Leo-Nicolle/open-pod/docs/tools/pinout.md

---
layout: PinoutLayout
sidebar: false
hero:
  name: Pinout
  tagline: Which STM32F446 pin drives what, on the final opentone board (LQFP100) and on the Nucleo-F446RE prototype (LQFP64). Assignments come from the firmware pin maps.
  actions:
    - text: LQFP100 full table
      link: /tools/pinout-table-lqfp100
      theme: alt
    - text: LQFP64 full table
      link: /tools/pinout-table
      theme: alt
---

<PinoutViewer />
