Leo-Nicolle/open-pod/notes/stm32_production_optimization.md

# STM32 Production Optimization: Eliminating Empty Function Call Overhead

When defining functions that are active via flags during development but empty in production, keeping them in a **separate file** causes standard file-by-file compilation to lose CPU cycles. 

Because the compiler evaluates each `.cpp` file independently, it cannot see that the function body in the other file is empty. It assumes code exists and emits a `BL` (Branch with Link) instruction, wasting critical CPU ticks in production.

---

## The Cost of Unoptimized Empty Functions

On an ARM Cortex-M processor (STM32), calling an unoptimized empty function in a separate file costs **4 to 8+ CPU cycles** due to assembly overhead:

| Operation | Typical STM32 Ticks | Description |
| :--- | :--- | :--- |
| **`BL` (Branch Link)** | **1 – 2 Ticks** | MCU jumps to the function address and saves the return address. |
| **Stack Pushing** | **1 – 4+ Ticks** | Registers are pushed to the stack to preserve state. |
| **`BX LR` (Return)** | **1 – 3 Ticks** | MCU jumps back to the original execution path. |

---

## 3 Strategies to Achieve 0 Ticks in Production

### 1. Link-Time Optimization (LTO)
* **Best for:** Keeping your current structure with separate `.cpp` files unchanged.
* **How it works:** Instructs the linker to optimize across all compilation units. It catches the empty body at the final stage and strips out the call entirely.
* **PlatformIO Configuration (`platformio.ini`):**
  ```ini
  [env:your_stm32_board]
  platform = ststm32
  board = your_board
  framework = stm32cube ; or arduino
  build_flags = 
      -flto         ; Enables Link-Time Optimization
  ```

### 2. Header-Based Inline Functions
* **Best for:** Explicit control within C/C++ architecture without forcing global LTO.
* **How it works:** Shifting the `#ifdef` logic into the header file (`.h`) using the `inline` keyword. This gives the compiler full visibility in every file where it is included, guaranteeing zero-tick omission.
* **Implementation (`my_hooks.h`):**
  ```cpp
  #ifndef MY_HOOKS_H
  #define MY_HOOKS_H

  #ifdef ENABLE_DEBUG_FLAGS
      void myHook(); // Body lives in the .cpp file for debug mode
  #else
      inline void myHook() {} // Production mode: optimized to 0 ticks
  #endif

  #endif
  ```

### 3. Preprocessor Macro Stripping
* **Best for:** Purely architectural instrumentation, telemetry, or debug logging.
* **How it works:** Replaces the function signature entirely with a no-op macro before compilation even starts.
* **Implementation (`my_hooks.h`):**
  ```cpp
  #ifdef ENABLE_DEBUG_FLAGS
      void myHook();
  #else
      #define myHook() ((void)0) // Completely erased in production
  #endif
  ```
