Leo-Nicolle/open-pod/docs/tools/memory-layout.md

---
aside: false
---

# Memory layout

Where every byte of the firmware's memory goes: the STM32F446's 128 KB of internal RAM (static data, heap and stack) and the 8 MB PSRAM next to it. Hover a block for its size, click it to open its details and see what's inside; the table below lists every allocation with the file and variable that owns it.

<MemoryLayout />
