Leo-Nicolle/open-pod/docs/tools/bench-compare.md

---
aside: false
---

# Compare bench reports

Put two [bench](./bench) reports side by side: the headline numbers first, then every figure of every scenario, matched by sample, query or step. A starts on the newest report saved in the repo's `benchmarks/` folder; drop the one you just downloaded from the [live bench](./bench-live) on B. Nothing leaves the browser.

<BenchCompare />
