Leo-Nicolle/open-pod/software/src/sound/FLAC_README.md

# FLAC Support for VS1053b Audio Decoder

## Overview

This implementation provides FLAC (Free Lossless Audio Codec) support for the VS1053b audio decoder chip. FLAC support requires a software plugin to be loaded into the VS1053b's internal memory.

## Implementation Status

### Current Implementation

- ✅ FLAC plugin loading framework
- ✅ Clock configuration 0xC000 (4.5x = 55.3 MHz; SC_ADD only helps WMA/AAC, so the old 0x8800 ran FLAC at 3.5x)
- ✅ Plugin verification methods
- ✅ Integration with AudioPlayer class
- ⚠️ **Placeholder plugin data** (demonstration only)

### What's Needed for Production

- 🔄 **Complete FLAC plugin data from VLSI Solution**
- 🔄 Full 8208-word plugin arrays (atab and dtab)

## How FLAC Plugin Works

### Plugin Loading Process

1. **Clock Configuration**: Set VS1053b clock to 0xC000 (4.5x multiplier)
2. **Plugin Loading**: Iterate through 8208 data words:
   ```cpp
   for (uint16_t i = 0; i < 8208; i++) {
     writeRegister(atab[i], dtab[i]);
     waitForDREQ();
   }
   ```
3. **Verification**: Check clock configuration and chip responsiveness

### Working Example Structure

Based on the working FLAC driver example provided:

```cpp
// Address table - specifies register addresses
const uint8_t atab[8208] = { /* complete address data */ };

// Data table - actual plugin code and data
const uint16_t dtab[8208] = { /* complete plugin data */ };

// Loading methodology
for (uint16_t i = 0; i < 8208; i++) {
  VS1053_SciWrite(atab[i], dtab[i]);
}
```

## Obtaining Complete Plugin Data

### Official Source

The complete FLAC plugin must be obtained from **VLSI Solution** (the VS1053b manufacturer):

- Website: https://www.vlsi.fi/
- Product: VS1053b FLAC Decoder Plugin
- License: Check VLSI Solution's licensing terms

### Plugin Specifications

- **Size**: 8208 words (16,416 bytes)
- **Format**: Two arrays - address table (atab) and data table (dtab)
- **Capability**: FLAC decoding up to 48kHz/24-bit
- **Memory**: Loaded into VS1053b internal RAM

## File Structure

### Current Files

- [`VS1053_FLAC_plugin.h`](VS1053_FLAC_plugin.h) - Plugin data header (placeholder)
- [`VS1053_driver.h`](VS1053_driver.h) - FLAC method declarations
- [`VS1053_driver_config.cpp`](VS1053_driver_config.cpp) - FLAC plugin loading implementation

### Key Methods

```cpp
bool loadFLACPlugin();           // Load complete FLAC plugin
bool isFLACPluginLoaded();       // Verify plugin is loaded
void writeFLACPluginData(...);   // Write plugin data helper
```

## Integration with AudioPlayer

### FLAC File Detection

```cpp
// In AudioPlayer.cpp
if (isFlac) {
  if (!_driver.loadFLACPlugin()) return false;
  if (!_driver.isFLACPluginLoaded()) return false;
}
```

### Usage Example

```cpp
// Test FLAC playback
audioPlayer.startPlaying("track.flac");
```

## Technical Details

### Clock Configuration

- **FLAC Clock**: 0xC000 (4.5x multiplier)
- **Internal Clock**: ~55MHz with 12.288MHz crystal
- **Purpose**: Provides sufficient processing power for FLAC decoding

### Memory Requirements

- **Plugin Size**: 8208 words in VS1053b RAM
- **Arduino Memory**: ~16KB for plugin data arrays
- **Loading Time**: ~8-10 seconds (with progress indication)

### Performance

- **Supported Formats**: FLAC up to 48kHz/24-bit
- **Decoding**: Hardware-accelerated after plugin loading
- **Quality**: Lossless audio reproduction

## Development Notes

### Current Limitations

1. **Placeholder Data**: Current implementation uses demonstration data
2. **Plugin Source**: Complete plugin must be obtained separately
3. **License**: Check VLSI Solution licensing for commercial use

### Testing Status

- ✅ Plugin loading framework tested
- ✅ Clock configuration verified
- ⚠️ FLAC playback requires complete plugin data

### Next Steps

1. Obtain complete FLAC plugin from VLSI Solution
2. Replace placeholder arrays in `VS1053_FLAC_plugin.h`
3. Test with actual FLAC files
4. Optimize loading time if needed

## Troubleshooting

### Common Issues

1. **Plugin Not Loading**: Check SPI communication and DREQ timing
2. **Clock Issues**: Verify 0xC000 clock configuration
3. **Memory Issues**: Ensure sufficient Arduino memory for plugin arrays

### Debug Output

The implementation provides detailed debug output:

```
Loading FLAC plugin...
Configuring clock for FLAC plugin...
Loading FLAC plugin data (8208 words)...
Plugin loading progress: 0/8208
Plugin loading progress: 1000/8208
...
FLAC plugin loaded successfully
```

## References

- [VS1053b Datasheet](https://www.vlsi.fi/fileadmin/datasheets/vs1053.pdf)
- [VLSI Solution FLAC Plugin](https://www.vlsi.fi/)
- [Working FLAC Driver Example](provided by user)

---

**Note**: This implementation provides the framework for FLAC support. Complete functionality requires the official FLAC plugin data from VLSI Solution.
