Leo-Nicolle/open-pod/docs/pinout.md

---
# Redirect stub: this page moved to /tools/pinout
head:
  - - meta
    - http-equiv: refresh
      content: 0; url=/tools/pinout
sitemap: false
---

This page moved to [Tools › pinout](/tools/pinout).
