Leo-Nicolle/open-pod/docs/pinout-table.md

---
# Redirect stub: this page moved to /tools/pinout-table
head:
  - - meta
    - http-equiv: refresh
      content: 0; url=/open-pod/tools/pinout-table
sitemap: false
---

This page moved to [Tools › pinout-table](/tools/pinout-table).
