Leo-Nicolle/open-pod/docs/clickwheel.md

---
# Redirect stub: this page moved to /tools/clickwheel
head:
  - - meta
    - http-equiv: refresh
      content: 0; url=/open-pod/tools/clickwheel
sitemap: false
---

This page moved to [Tools › clickwheel](/tools/clickwheel).
