Leo-Nicolle/open-pod/docs/tools/bench-live.md

---
aside: false
sidebar: false
pageClass: bench-live-page
---

# Live bench

Watch the bench firmware live, drive the pod from here, and run the [benchmark](./bench) scenarios from the browser. The page talks to the Nucleo straight over USB with Web Serial (Chrome or Edge on desktop), so nothing needs installing. Without a board, <a href="?demo">try the demo</a>, which simulates one.

<BenchLive />

How to set it up, and what each chart shows: [Using the live bench](./bench#using-the-live-bench).
