Leo-Nicolle/open-pod/hardware/clickwheel.png

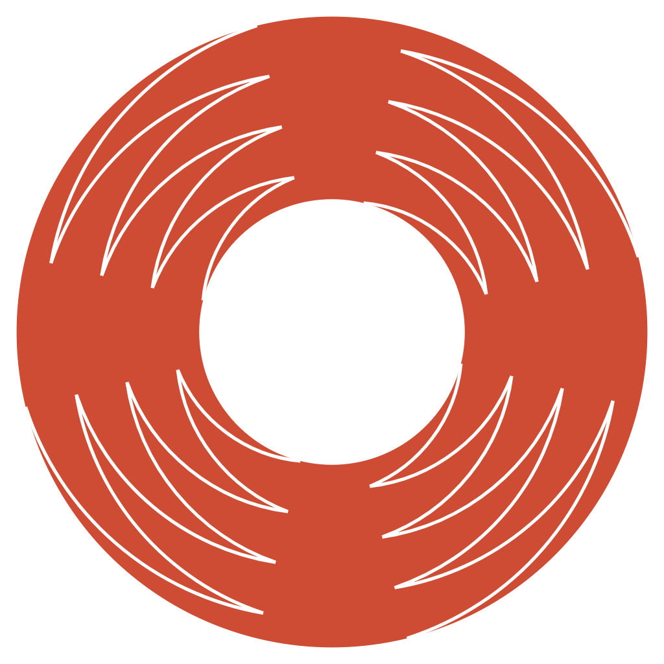
hardware/clickwheel.png
