Leo-Nicolle/open-pod/hardware/3dmodels/hirose-connector-8.stp

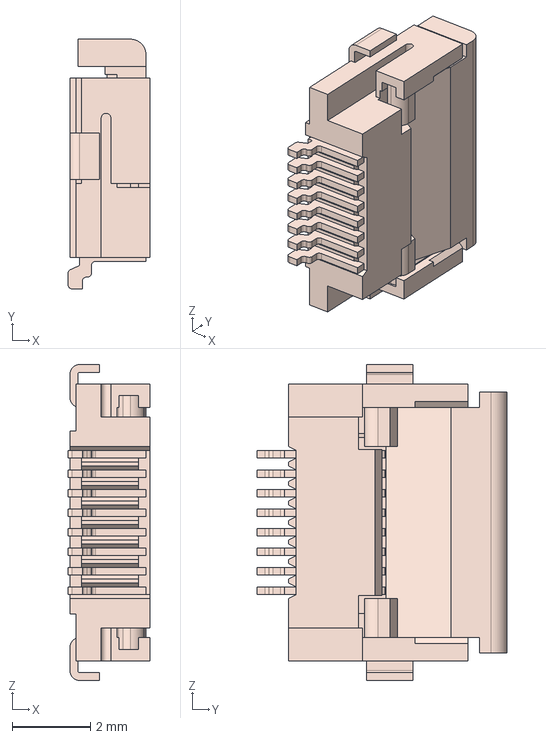
[picture p6: CAD file, 2025-07-06]
hardware/3dmodels/hirose-connector-8.stp
2.10 x 6.40 x 8.10 mm
