Leo-Nicolle/open-pod/hardware/openpod/jack/SJ-43515TS-SMT-TR.step

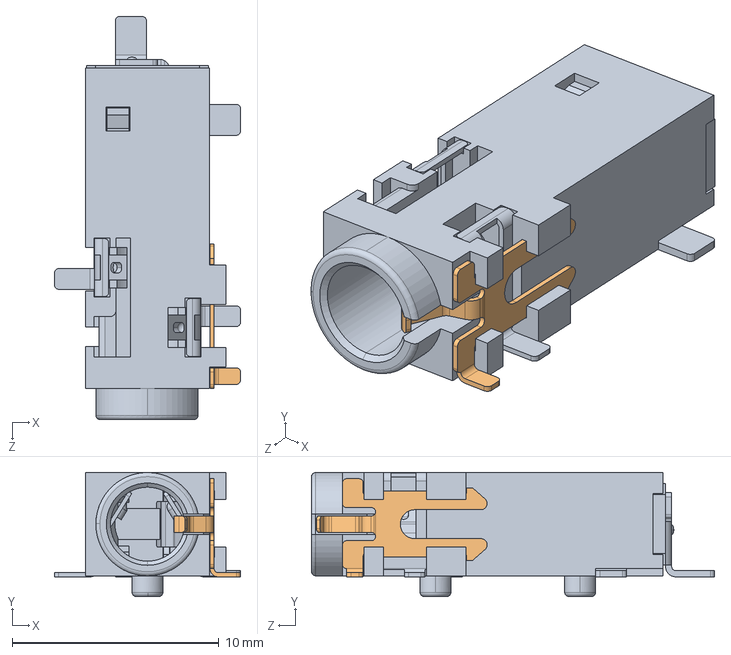
[picture p7: CAD file, 2025-05-11]
hardware/openpod/jack/SJ-43515TS-SMT-TR.step
9.00 x 6.00 x 19.5 mm
