Leo-Nicolle/open-pod/hardware/3dmodels/hirose-connector-40.stp

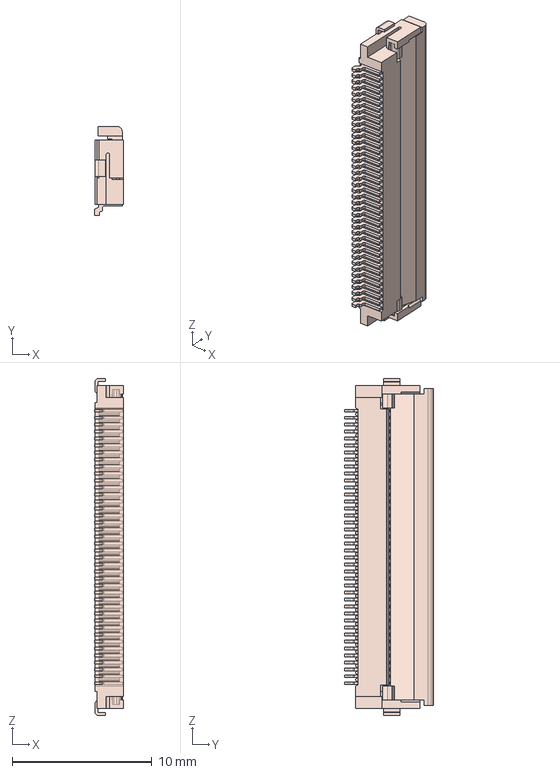
[picture p8: CAD file, 2025-05-11]
hardware/3dmodels/hirose-connector-40.stp
2.10 x 6.40 x 24.1 mm
