Leo-Nicolle/open-pod/hardware/3dmodels/NHD-2.4-240320CF-Cxxx#-F.STEP

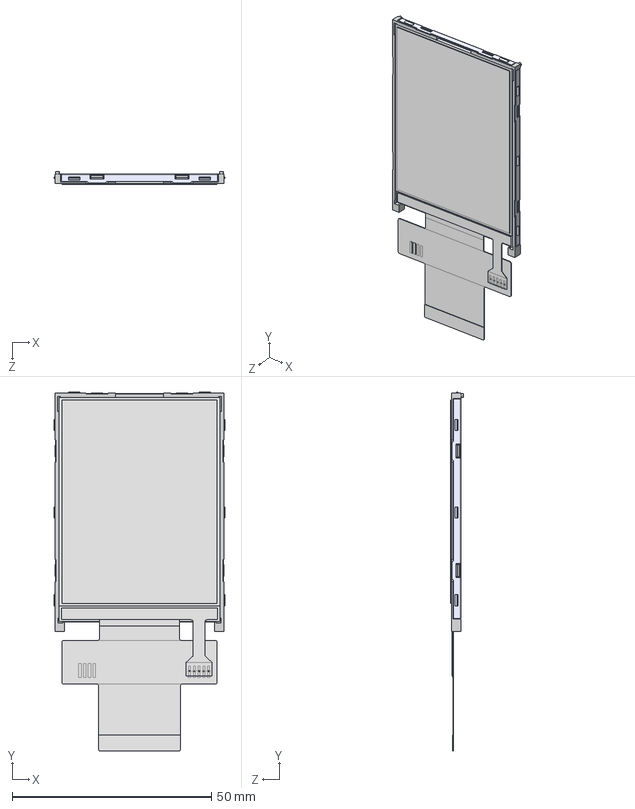
[picture p9: CAD file, 2025-05-11]
hardware/3dmodels/NHD-2.4-240320CF-Cxxx#-F.STEP
42.9 x 90.2 x 3.17 mm
bezel 2
V.A
Cable
Cable 2
frame
lens
