Leo-Nicolle/open-pod/hardware/3dmodels/SKQGAF.STEP

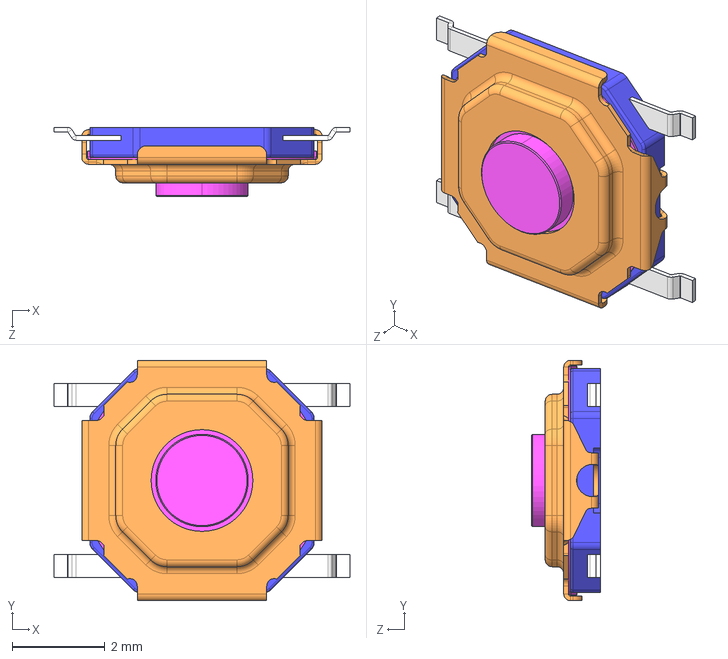
[picture p10: CAD file, 2025-05-11]
hardware/3dmodels/SKQGAF.STEP
6.40 x 5.20 x 1.50 mm
