Leo-Nicolle/open-pod/hardware/3dmodels/Same_Sky_SJ-43514-SMT-TR.step

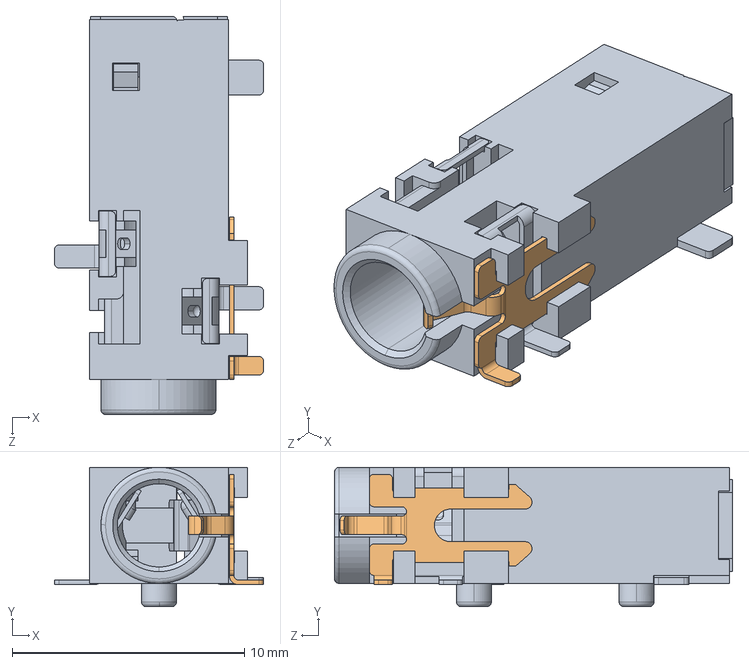
[picture p11: CAD file, 2025-05-11]
hardware/3dmodels/Same_Sky_SJ-43514-SMT-TR.step
9.00 x 6.00 x 17.1 mm
