Leo-Nicolle/open-pod/(list of files, cad)

Other CAD files:
hardware/parts/clickwheel-dev-holder.blend
