Leo-Nicolle/open-pod/docs/ui-builder.md

---
# Redirect stub: this page moved to /tools/ui-builder
head:
  - - meta
    - http-equiv: refresh
      content: 0; url=/tools/ui-builder
sitemap: false
---

This page moved to [Tools › ui-builder](/tools/ui-builder).
