Leo-Nicolle/open-pod/hardware/openpod/bt_devboard.kicad_pcb

## KiCad design hardware/openpod/bt_devboard.kicad_pcb (2026-09-20)

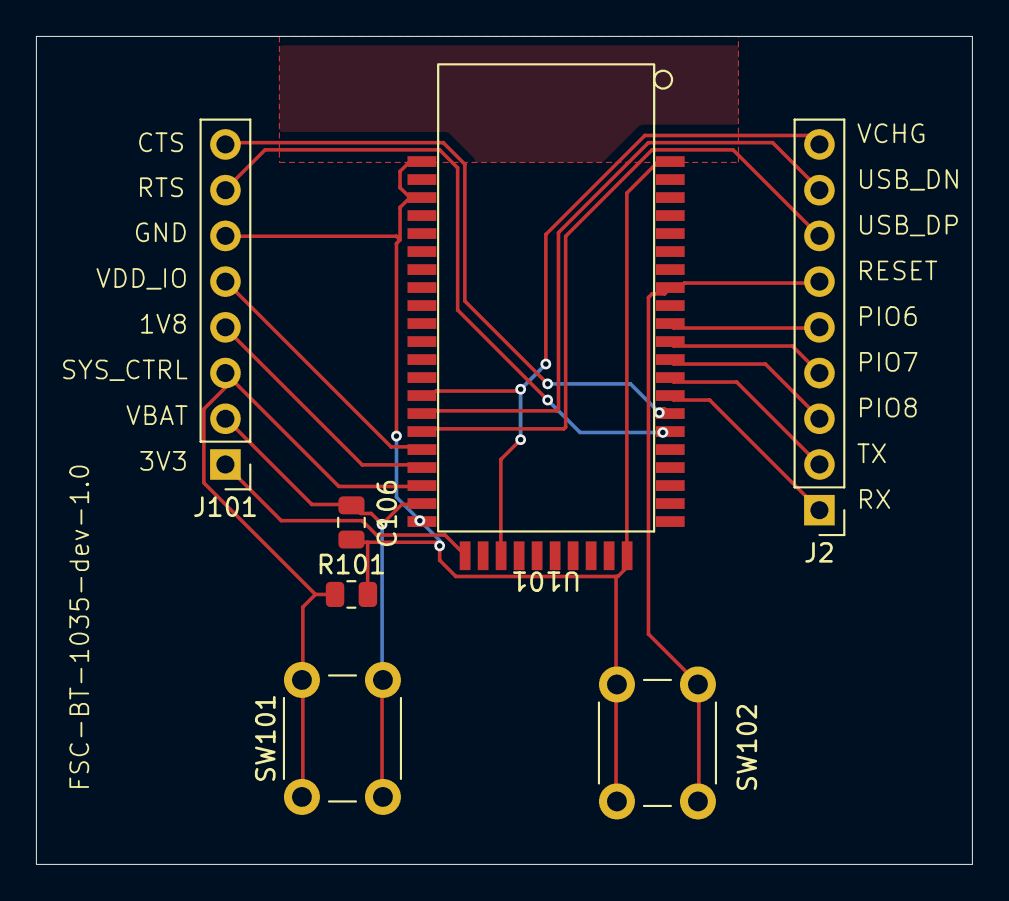
[picture p12: board bt_devboard.kicad_pcb from above]

Board: 2 copper layers, 52.0 x 46.0 mm, 7 parts (0 on the bottom side), 17 nets.

Parts:
C106: 10u; C_0805_2012Metric
J2: Conn_01x09; PinHeader_1x09_P2.54mm_Vertical
J101: POWER; PinHeader_1x08_P2.54mm_Vertical
R101: 100k; R_0805_2012Metric
SW101: PWR; SW_PUSH_6mm_H4.3mm
SW102: RST; SW_PUSH_6mm_H4.3mm
U101: FSC-BT1035; fsc-bt1035

Connections:
/BT_1V8: J101.4, U101.35 (1.8V_OUT)
/BT_3V3: J101.1, U101.31 (VDD_USB/3.3V_OUT)
/BT_CTS: J101.8, U101.15 (BT_CTS/PIO3)
/BT_GND: C106.2, J101.6, R101.2, SW102.2, U101.1 (GND), U101.22 (GND), U101.32 (GND), U101.50 (GND), U101.52 (GND)
/BT_PIO6: J2.5, U101.10 (PIO6)
/BT_PIO7: J2.4, U101.11 (PIO7)
/BT_PIO8: J2.3, U101.12 (PIO8)
/BT_RESET: J2.6, SW102.1, U101.8 (RESET)
/BT_RTS: J101.7, U101.16 (BT_RTS/PIO2)
/BT_RX: J2.1, U101.14 (BT_RX/PIO4)
/BT_SYS_CTRL: J101.3, R101.1, SW101.1, U101.34 (SYS_CTRL)
/BT_TX: J2.2, U101.13 (BT_TX/PIO5)
/BT_USB_DN: J2.8, U101.38 (USB_D-)
/BT_USB_DP: J2.7, U101.37 (USB_D+)
/BT_VBAT: C106.1, J101.2, SW101.2, U101.33 (VBAT_IN)
/BT_VCHG: J2.9, U101.29 (VCHG_SENSE), U101.39 (VCHG)
/BT_VDD_IO: J101.5, U101.36 (VDD_IO)
