Leo-Nicolle/open-pod/hardware/openpod/openpod.kicad_pcb

## KiCad design hardware/openpod/openpod.kicad_pcb (2026-09-20)

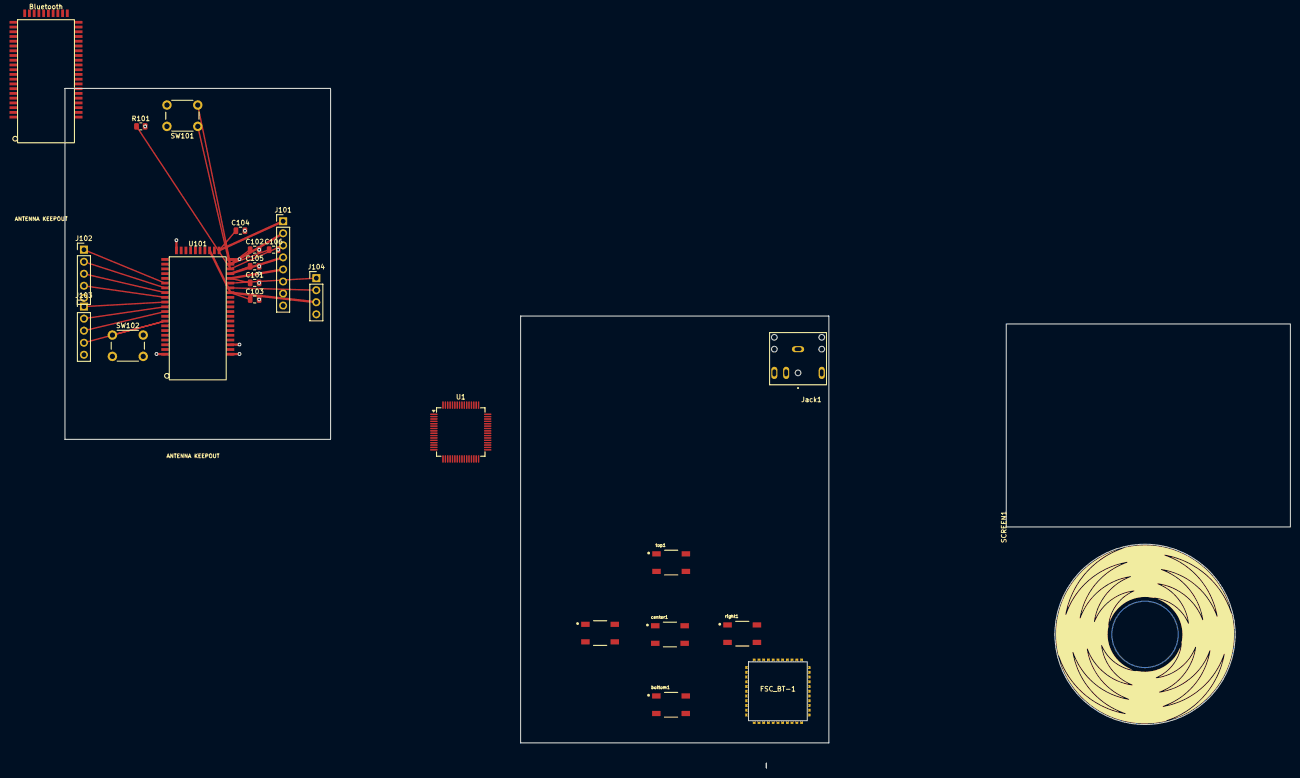
[picture p13: board openpod.kicad_pcb from above]

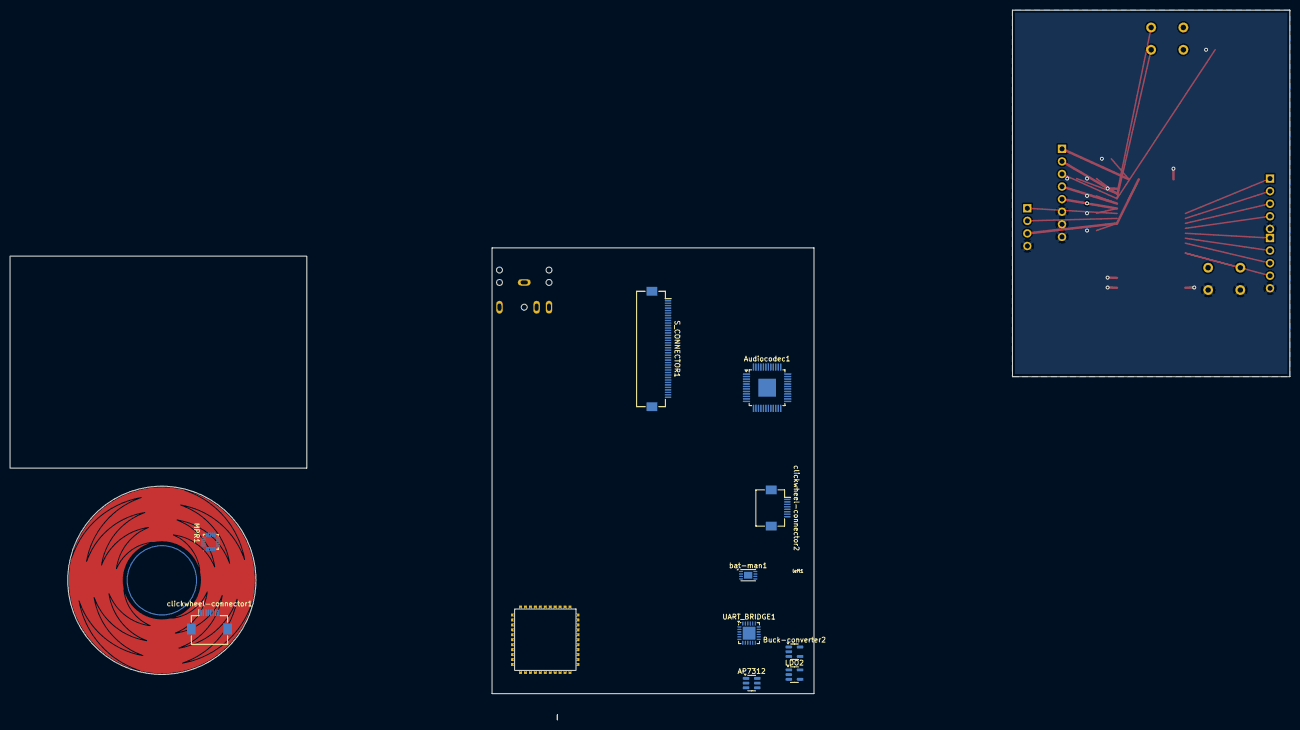
[picture p14: board openpod.kicad_pcb from below]

Board: 2 copper layers, 258.4 x 143.3 mm, 35 parts (10 on the bottom side), 42 nets.

Parts:
AP7312: SOT-23-6
Audiocodec1: VS1063; LQFP-48-1EP_7x7mm_P0.5mm_EP3.6x3.6mm
Bluetooth: fsc-bt1035
Buck-converter2: LM3671; TSOT-23-5
C101, C102, C103, C104, C105: 100n; C_0805_2012Metric
C106: 10u; C_0805_2012Metric
Clickwheel1: clickwheel_1
FSC_BT-1: fsc-bt1046
J101: POWER; PinHeader_1x08_P2.54mm_Vertical
J102: UART; PinHeader_1x05_P2.54mm_Vertical
J103: DEBUG; PinHeader_1x05_P2.54mm_Vertical
J104: USB; PinHeader_1x04_P2.54mm_Vertical
Jack1: SJ1-3524NG; CUI_SJ1-3524NG
LDO2: MIC5504-3.3YM5; SOT-23-5
MPR1: MPR121QR2; mpr121qr2
R101: 100k; R_0805_2012Metric
SCREEN1: nhd-2.4-240320cf-ctxif
SW101: PWR; SW_PUSH_6mm_H4.3mm
SW102: RST; SW_PUSH_6mm_H4.3mm
S_CONNECTOR1: Hirose_FH12-40S-0.5SH_1x40-1MP_P0.50mm_Horizontal
U1: STM32F446RCTx; LQFP-64_10x10mm_P0.5mm
U101: FSC-BT1035; fsc-bt1035
UART_BRIDGE1: CP2102N-Axx-xQFN24; QFN-24-1EP_4x4mm_P0.5mm_EP2.6x2.6mm
bat-man1: MCP73831-2-MC; DFN-8-1EP_3x2mm_P0.5mm_EP1.7x1.4mm
bottom1: SKQGAFE010; SW_SKQGAFE010
center1: SKQGAFE010; SW_SKQGAFE010
clickwheel-connector1, clickwheel-connector2: Hirose_FH12-8S-0.5SH_1x08-1MP_P0.50mm_Horizontal
left1: SKQGAFE010; SW_SKQGAFE010
right1: SKQGAFE010; SW_SKQGAFE010
top1: SKQGAFE010; SW_SKQGAFE010

Connections:
3.3-audio: AP7312.1 (OUT2), LDO2.5 (VOUT)
3.3V: LDO2.1 (VIN), LDO2.3 (EN)
+3.3V: AP7312.3 (EN2), AP7312.4 (EN1), AP7312.5 (IN)
AVDD: Audiocodec1.38 (AVDD0), Audiocodec1.43 (AVDD1), Audiocodec1.45 (AVDD2)
BT_1V8: C105.1, J101.4, U101.35
BT_3V3: C104.1, J101.1, U101.31
BT_CTS: J102.2, U101.15
BT_GND: C101.2, C102.2, C103.2, C104.2, C105.2, C106.2, J101.6, J101.7, J101.8, J102.5, J103.5, J104.4, R101.2, SW102.2, U101.1, U101.22, U101.32, U101.50, U101.52
BT_PIO6: J103.3, U101.10
BT_PIO7: J103.2, U101.11
BT_PIO8: J103.1, U101.12
BT_RESET: J103.4, SW102.1, U101.8
BT_RTS: J102.1, U101.16
BT_RX: J102.3, U101.14
BT_SYS_CTRL: J101.3, R101.1, SW101.1, U101.34
BT_TX: J102.4, U101.13
BT_USB_DN: J104.2, U101.38
BT_USB_DP: J104.1, U101.37
BT_VBAT: C102.1, C106.1, J101.2, SW101.2, U101.33
BT_VCHG: C103.1, J104.3, U101.29, U101.39
BT_VDD_IO: C101.1, J101.5, U101.36
CVDD: Audiocodec1.5 (CVDD0), Audiocodec1.7 (CVDD1), Audiocodec1.24 (CVDD2), Audiocodec1.31 (CVDD3)
GND: AP7312.2 (GND), Audiocodec1.4 (DGND0), Audiocodec1.16 (DGND1), Audiocodec1.20 (DGND2), Audiocodec1.21 (DGND3), Audiocodec1.22 (DGND4), Audiocodec1.35 (GND), Audiocodec1.37 (AGND0), Audiocodec1.40 (AGND1), Audiocodec1.41 (AGND2), Audiocodec1.47 (AGND3), Bluetooth.1, Bluetooth.22, Bluetooth.32, Buck-converter2.2 (GND), LDO2.2 (GND), UART_BRIDGE1.2 (GND), UART_BRIDGE1.25 (GND), bat-man1.6 (V_{SS})
GPIO_PULL: Audiocodec1.9 (GPIO2/DCLK), Audiocodec1.10 (GPIO3/SDATA), Audiocodec1.11 (GPIO6/I2S_SCLK), Audiocodec1.12 (GPIO7/I2S_SDATA), Audiocodec1.25 (GPIO5/I2S_MCLK), Audiocodec1.33 (GPIO0), Audiocodec1.34 (GPIO1), Audiocodec1.36 (GPIO4/I2S_LROUT)
IOVDD: Audiocodec1.6 (IOVDD0), Audiocodec1.14 (IOVDD1), Audiocodec1.19 (IOVDD2), Audiocodec1.32 (XTEST)
unnamed: Buck-converter2.3 (EN), Buck-converter2.4 (FB)
unnamed: UART_BRIDGE1.5 (VIO), UART_BRIDGE1.6 (VDD)
unnamed: bat-man1.1 (V_{DD}), bat-man1.2 (V_{DD})
unnamed: Clickwheel1.1 (top), MPR1.16 (ELEC8)
unnamed: Clickwheel1.2 (right), MPR1.15 (ELEC7)
unnamed: Clickwheel1.3 (bottom), MPR1.19 (ELEC11)
unnamed: Clickwheel1.4 (left), MPR1.9 (ELEC1)
unnamed: MPR1.1 (~IRQ), clickwheel-connector1.2 (IRQ)
unnamed: MPR1.2 (SCL), clickwheel-connector1.3 (SCL)
unnamed: MPR1.3 (SDA), clickwheel-connector1.4 (SDA)
unnamed: MPR1.4 (ADDR), clickwheel-connector1.5 (ADDR)
unnamed: MPR1.5 (VREG), clickwheel-connector1.6 (VREG)
unnamed: MPR1.6 (VSS), clickwheel-connector1.7 (VSS)
unnamed: MPR1.7 (REXT), clickwheel-connector1.8 (REXT)
unnamed: MPR1.20 (VDD), clickwheel-connector1.1 (VDD)
unnamed: U1.18 (VSS), U1.31 (VSS), U1.47 (VSS), U1.63 (VSS)
VBAT: bat-man1.3 (V_{BAT}), bat-man1.4 (V_{BAT})
