Leo-Nicolle/open-pod/software/src/rendering/ILI9341_GFX.h

#pragma once
#include "rendering/ILI9341_driver.h"
#include "sound/Spi1Bus.h"
#include "logging.h"
#include "ui/theme.h" // diagnostic-only: lets runDisplayDiagnostics() test the
                       // app's actual COLOR_* values, not just generic test colors
#include <Adafruit_GFX.h>
#include <Arduino.h>

class ILI9341_GFX : public Adafruit_GFX, public ILI9341_Driver {

public:
  // Constructor - Initialize Adafruit_GFX with display dimensions
  ILI9341_GFX() : Adafruit_GFX(320, 240) {}

  void begin() {
    setupPins();
    initILI9341();
    setRotation(0);
  }

  // Required Adafruit_GFX virtual methods
  void drawPixel(int16_t x, int16_t y, uint16_t color) override {
    if ((x < 0) || (x >= _width) || (y < 0) || (y >= _height))
      return;

    setWindow(x, y, x, y);
    writeData16(color);
  }

  // Bulk pixel transfers hold the SPI1 lock, in slices of PIXEL_SLICE
  // pixels: the VS1053 feeder interrupt then never clocks SPI1 while the 16
  // parallel data lines are switching at full speed (on the breadboard
  // wiring that corrupted bits on their way to the VS1053: audible glitches
  // while scrolling/animating, with on-time, complete feeding). Slicing
  // keeps each hold short (~0.15 ms) even across a long animation of
  // back-to-back transfers; a feeder tick that found the bus busy runs as
  // soon as the slice releases it (see spi1bus::release()). Pausing between
  // pixels is invisible to the panel.
  static const uint32_t PIXEL_SLICE = 1024;

  void fillRect(int16_t x, int16_t y, int16_t w, int16_t h,
                uint16_t color) override {
    if ((x >= _width) || (y >= _height))
      return;

    int16_t x2 = x + w - 1, y2 = y + h - 1;
    if ((x2 < 0) || (y2 < 0))
      return;

    // Clip to screen boundaries
    if (x < 0) {
      w += x;
      x = 0;
    }
    if (y < 0) {
      h += y;
      y = 0;
    }
    if (x2 >= _width) {
      w = _width - x;
    }
    if (y2 >= _height) {
      h = _height - y;
    }

    setWindow(x, y, x + w - 1, y + h - 1);
    fillPixels(color, (uint32_t)w * h);
  }

  // HIGH PERFORMANCE: Push array of pixels
  void pushPixels(uint16_t *colors, uint32_t count) {
    digitalWrite(TFT_DC, HIGH); // Data mode
    while (count > 0) {
      uint32_t n = count < PIXEL_SLICE ? count : PIXEL_SLICE;
      {
        spi1bus::Lock busLock;
        pushPixelSlice(colors, n);
      }
      colors += n;
      count -= n;
    }
  }

  // Push pixels with DMA support (if you add DMA later)
  void pushPixelsDMA(uint16_t *colors, uint32_t count) {
    // For now, fall back to regular push
    pushPixels(colors, count);

    // TODO: Implement DMA transfer
    // This would use DMA2 to transfer from memory to GPIOC->ODR
    // with hardware triggering of WR signal
  }

  // Optimized window push - send pixels to a defined window area
  void pushWindow(int16_t x, int16_t y, int16_t w, int16_t h,
                  uint16_t *colors) {
    // w*h is computed in signed 16/32-bit math; if a caller ever passes a
    // non-positive w or h (e.g. a transient negative width mid-animation),
    // the product goes negative and then silently wraps to a huge uint32_t
    // when handed to pushPixels() below - which turns into a multi-billion
    // iteration GPIO loop that looks exactly like a hang. Refuse it here,
    // before that conversion happens.
    if (w <= 0 || h <= 0)
      return;
    setWindow(x, y, x + w - 1, y + h - 1);
    pushPixels(colors, (uint32_t)w * (uint32_t)h);
  }

  // Fast vertical scroll (hardware accelerated if supported)
  void verticalScroll(int16_t top, int16_t scrolllines, int16_t offset) {
    // ILI9341 supports hardware scrolling
    writeCommand(0x33); // Vertical Scrolling Definition
    writeData16(top);
    writeData16(scrolllines);
    writeData16(320 - top - scrolllines); // Bottom fixed area

    writeCommand(0x37); // Vertical Scrolling Start Address
    writeData16(offset);
  }

  void drawFastVLine(int16_t x, int16_t y, int16_t h, uint16_t color) override {
    fillRect(x, y, 1, h, color);
  }

  void drawFastHLine(int16_t x, int16_t y, int16_t w, uint16_t color) override {
    fillRect(x, y, w, 1, color);
  }

  void fillScreen(uint16_t color) override {
    setWindow(0, 0, _width - 1, _height - 1);
    fillPixels(color, (uint32_t)_width * _height);
  }

  // Writes `pixels` copies of `color` into the current window, in locked
  // slices (see PIXEL_SLICE).
  void fillPixels(uint16_t color, uint32_t pixels) {
    digitalWrite(TFT_DC, HIGH); // Data mode
#ifdef BROKEN_NUCLEO
    // color is constant for the whole fill, so the relocated D14/D15 pins
    // only need setting once - they hold their level across every
    // pulseWR(). See the BROKEN_NUCLEO note in ILI9341_driver.h.
    writeBrokenBits(color);
#endif
    volatile uint32_t &bus = portCReg();
    const uint32_t word = portCWord(color);
    while (pixels > 0) {
      uint32_t n = pixels < PIXEL_SLICE ? pixels : PIXEL_SLICE;
      pixels -= n;
      spi1bus::Lock busLock;
      while (n >= 8) {
        bus = word;
        pulseWR();
        bus = word;
        pulseWR();
        bus = word;
        pulseWR();
        bus = word;
        pulseWR();
        bus = word;
        pulseWR();
        bus = word;
        pulseWR();
        bus = word;
        pulseWR();
        bus = word;
        pulseWR();
        n -= 8;
      }
      while (n--) {
        bus = word;
        pulseWR();
      }
    }
  }

  // One slice of pushPixels(); the caller holds the bus lock.
  void pushPixelSlice(uint16_t *colors, uint32_t count) {
#ifdef BROKEN_NUCLEO
    // Unlike fills, the color changes every pixel here, so D14/D15
    // (relocated to PA0/PA1, see ILI9341_driver.h) need a fresh
    // writeBrokenBits() call each iteration.
    while (count--) {
      uint16_t px = *colors++;
      GPIOC->BSRR = portCWord(px);
      writeBrokenBits(px);
      pulseWR();
    }
#else
    while (count >= 8) {
      GPIOC->ODR = *colors++;
      pulseWR();
      GPIOC->ODR = *colors++;
      pulseWR();
      GPIOC->ODR = *colors++;
      pulseWR();
      GPIOC->ODR = *colors++;
      pulseWR();
      GPIOC->ODR = *colors++;
      pulseWR();
      GPIOC->ODR = *colors++;
      pulseWR();
      GPIOC->ODR = *colors++;
      pulseWR();
      GPIOC->ODR = *colors++;
      pulseWR();
      count -= 8;
    }
    while (count--) {
      GPIOC->ODR = *colors++;
      pulseWR();
    }
#endif
  }

  void setupScroll(uint16_t TF, uint16_t scrollHeight, uint16_t BF) {
    // For landscape mode (rotation = 1), scrolling is horizontal visually
    // but still uses the vertical scroll registers internally

    // Set the scrollable region to full height (usually 240px)
    writeCommand(0x33); // VSCRDEF
    writeData(TF >> 8); // Top Fixed Area (TFA)
    writeData(TF & 0xFF);
    writeData(scrollHeight >> 8); // Vertical Scroll Area
    writeData(scrollHeight & 0xFF);
    writeData(BF >> 8); // Bottom Fixed Area (BFA)
    writeData(BF & 0xFF);
  }

  void setScrollOffset(uint16_t offset) {
    // For rotation 1, this visually scrolls from right to left
    writeCommand(0x37); // VSCRSADD
    writeData(offset >> 8);
    writeData(offset & 0xFF);
  }

  void setRotation(uint8_t r) override {
    rotation = r & 3;
    switch (rotation) {
    case 0: // 320x240 landscape
      _width = 320;
      _height = 240;
      writeCommand(0x36);
      writeData(0xE8);
      break;
    case 1: // 240x320 portrait
      _width = 240;
      _height = 320;
      writeCommand(0x36);
      writeData(0x48);
      break;
    case 2: // 320x240 landscape flipped
      _width = 320;
      _height = 240;
      writeCommand(0x36);
      writeData(0x28);
      break;
    case 3: // 240x320 portrait flipped
      _width = 240;
      _height = 320;
      writeCommand(0x36);
      writeData(0x88);
      break;
    }
  }

  void invertDisplay(bool i) { writeCommand(i ? 0x21 : 0x20); }

  // Off: DISPOFF + SLPIN (panel driver, oscillator and DC/DC stopped). On:
  // SLPOUT + DISPON. The MCU interface and GRAM keep working while asleep,
  // so the UI can still be drawn and turning it back on needs no redraw.
  // The datasheet asks 5ms after SLPIN/SLPOUT before the next command (and
  // 120ms between them, which the idle delay covers).
  void setDisplayOn(bool on)
  {
    if (on)
    {
      writeCommand(0x11); // Sleep Out
      delay(5);
      writeCommand(0x29); // Display ON
    }
    else
    {
      writeCommand(0x28); // Display OFF
      writeCommand(0x10); // Sleep In
      delay(5);
    }
  }

  // Hardware bring-up diagnostics for a hand-wired 16-bit parallel bus.
  // Two independent checks, run slowly enough to read off a photo/serial log:
  //
  // 1) Solid-color pass: confirms the panel's RGB/BGR subpixel order matches
  //    the MADCTL BGR bit setRotation() writes (see setRotation() above, bit
  //    0x08 in every mode). If RED prints but the panel shows blue (and BLUE
  //    shows red), the wiring/bus is fine and it's a MADCTL BGR-vs-RGB
  //    mismatch for that specific panel — flip bit 0x08 in setRotation() for
  //    that panel rather than re-checking wiring.
  //
  // 2) Data-bus walk: draws one vertical stripe per data line, D0 (left) to
  //    D15 (right), each stripe lit by only that bit (color = 1 << bit). A
  //    stripe that stays black means that line isn't reaching the panel
  //    (bad solder joint, unseated FPC pin, or broken wire) — read off which
  //    bit is dark to know exactly which physical pin to re-check. D0-D4 and
  //    part of D5-D10 are Blue/Green (low half of the bus, PC0-PC7); D8-D15
  //    carry the rest of Green plus all of Red (PC8-PC15) — a bad line up
  //    there reads as "everything is too blue" even when D0-D7 are perfect.
  void runDisplayDiagnostics() {
    struct Solid {
      uint16_t color;
      const char *name;
    };
    Solid solids[] = {
        {0xF800, "RED"},   {0x07E0, "GREEN"}, {0x001F, "BLUE"},
        {0xFFFF, "WHITE"}, {0x8410, "GREY (50%)"}, {0x0000, "BLACK"},
    };

    LOG_INFO("=== Display diagnostics: solid color pass ===");
    for (auto &s : solids) {
      LOG_INFO("Filling screen with %s", s.name);
      fillScreen(s.color);
      delay(2000);
    }

    // Test the app's ACTUAL theme.h macro values directly, not just generic
    // test colors above - narrows whether this is about "near-black/white
    // in general" (already tested and clean) vs "this specific computed
    // value" (COLOR_BG, COLOR_TEXT etc. - what the real UI uses).
    Solid themed[] = {
        {COLOR_BG, "COLOR_BG"},       {COLOR_TEXT, "COLOR_TEXT"},
        {COLOR_DIM, "COLOR_DIM"},     {COLOR_MUTED, "COLOR_MUTED"},
        {COLOR_SURFACE, "COLOR_SURFACE"}, {COLOR_ACCENT, "COLOR_ACCENT"},
    };
    LOG_INFO("=== Display diagnostics: theme.h macro pass ===");
    for (auto &s : themed) {
      LOG_INFO("Filling screen with %s = 0x%X", s.name, s.color);
      fillScreen(s.color);
      delay(2000);
    }

    // pushPixels() is the ONLY path real UI content takes (nowplaying.hpp
    // composites background+text+art into a buffer, then does ONE
    // setWindow()+pushPixels() per chunk) - unlike fillScreen()/fillRect(),
    // which call writeBrokenBits() ONCE before their loop, pushPixels()
    // calls it PER PIXEL in a tight loop under BROKEN_NUCLEO. The solid
    // pass above never exercises that per-pixel path at all, so it can't
    // catch a bug specific to it (e.g. a setup-time issue when D14/D15
    // toggle every single pixel, as they do at a hard white-text-on-black
    // edge). This test forces exactly that: a fine black/white checkerboard
    // sent through pushPixels(), maximally alternating bits 14/15 on every
    // pixel.
    LOG_INFO("=== Display diagnostics: pushPixels rapid black/white alternation ===");
    {
      static uint16_t checkerRow[320];
      for (int i = 0; i < _width; i++) {
        checkerRow[i] = (i % 2 == 0) ? 0xFFFF : 0x0000;
      }
      setWindow(0, 0, _width - 1, 39);
      for (int row = 0; row < 40; row++) {
        pushPixels(checkerRow, _width);
      }
      delay(2000);
    }

    LOG_INFO("=== Display diagnostics: data bus walk (D0..D15, PC0-PC15) ===\n"
             "Left-most stripe = D0, right-most = D15. A black stripe = that "
             "line isn't getting through.");
    fillScreen(0x0000);
    int stripeWidth = _width / 16;
    for (int bit = 0; bit < 16; bit++) {
      fillRect(bit * stripeWidth, 0, stripeWidth, _height, (uint16_t)(1 << bit));
    }
    delay(2000);

    LOG_INFO("=== Display diagnostics done ===");
  }

  // Performance testing
  uint32_t testFillRate() {
    uint32_t start = micros();
    fillScreen(0xF800); // Red
    fillScreen(0x07E0); // Green
    fillScreen(0x001F); // Blue
    fillScreen(0x0000); // Black
    uint32_t elapsed = micros() - start;

    uint32_t pixels = (uint32_t)_width * _height * 4;        // 4 screens
    // MPixels/sec with 2 decimals (no %f in nano printf)
    uint32_t rate100 = elapsed ? (uint32_t)((uint64_t)pixels * 100 / elapsed) : 0;

    LOG_INFO("Fill rate: %lu.%02lu MPixels/sec", (unsigned long)(rate100 / 100),
             (unsigned long)(rate100 % 100));

    return elapsed;
  }
};
