Leo-Nicolle/open-pod/software/src/sound/startup_sound.h

#pragma once
// Startup sound, played over the title screen straight from flash (see
// AudioPlayer::playClip()). Generated from software/assets/startup.mp3, which
// is opentone-fast.wav encoded to fit the 32 KB audio fifo whole:
//   ffmpeg -i opentone-fast.wav -codec:a libmp3lame -b:a 96k -ar 44100 assets/startup.mp3
// then dump its bytes here (e.g. `xxd -i assets/startup.mp3`), keeping these names.
#include <stdint.h>

static const uint32_t STARTUP_SOUND_LEN = 27002;
static const uint8_t STARTUP_SOUND_MP3[27002] = {
  0x49,0x44,0x33,0x04,0x00,0x00,0x00,0x00,0x00,0x22,0x54,0x53,0x53,0x45,0x00,0x00,0x00,0x0E,0x00,0x00,
  0x03,0x4C,0x61,0x76,0x66,0x36,0x32,0x2E,0x33,0x2E,0x31,0x30,0x30,0x00,0x00,0x00,0x00,0x00,0x00,0x00,
  0x00,0x00,0x00,0x00,0xFF,0xFB,0x70,0x00,0x00,0x00,0x00,0x00,0x00,0x00,0x00,0x00,0x00,0x00,0x00,0x00,
  0x00,0x00,0x00,0x00,0x00,0x00,0x00,0x00,0x00,0x00,0x00,0x00,0x00,0x00,0x00,0x00,0x00,0x00,0x00,0x00,
  0x49,0x6E,0x66,0x6F,0x00,0x00,0x00,0x0F,0x00,0x00,0x00,0x55,0x00,0x00,0x69,0x4E,0x00,0x05,0x08,0x0B,
  0x0E,0x11,0x14,0x14,0x17,0x1A,0x1D,0x20,0x23,0x26,0x26,0x29,0x2C,0x2F,0x32,0x35,0x38,0x38,0x3B,0x3E,
  0x41,0x44,0x47,0x47,0x4A,0x4D,0x50,0x53,0x56,0x59,0x59,0x5C,0x5F,0x62,0x65,0x68,0x6B,0x6B,0x6E,0x71,
  0x74,0x77,0x7A,0x7A,0x7D,0x80,0x82,0x85,0x88,0x8B,0x8B,0x8E,0x91,0x94,0x97,0x9A,0x9D,0x9D,0xA0,0xA3,
  0xA6,0xA9,0xAC,0xAC,0xAF,0xB2,0xB5,0xB8,0xBB,0xBE,0xBE,0xC1,0xC4,0xC7,0xCA,0xCD,0xD0,0xD0,0xD3,0xD6,
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
  0xC6,0x14,0x95,0xAE,0xBA,0x44,0x1A,0x9C,0xB0,0x3D,0xD0,0xF9,0xCB,0x9B,0xE6,0x96,0xEF,0xE2,0xEC,0x54,
  0xF1,0xE0,0x50,0xE8,0x04,0x59,0x80,0x02,0xD7,0x98,0x93,0x88,0xA4,0xC1,0x54,0x7C,0x17,0xA9,0x66,0x08,
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
};
