Leo-Nicolle/open-pod/software/src/sound/Audio_buffer.cpp

#include "Audio_buffer.h"
#include "../logging.h"
#include "../storage/SharedSpiDriver.h"

Audio_buffer::Audio_buffer(uint8_t sdCS, SdFat &sd) : _sdCS(sdCS), _sd(sd) {
  // psram = nullptr;
  _psramBaseAddress = 0;
  resetRingBuffer();
}

Audio_buffer::~Audio_buffer() {
  // if (psram) {
    // delete psram;
    // psram = nullptr;
  // }
}

bool Audio_buffer::begin(uint32_t sdFreq) {
  if (!_sd.begin(OPENPOD_SD_CONFIG(_sdCS))) {
    LOG_ERROR("SD card initialization failed");
    return false;
  }
  initializePSRAM();
  return true;
}

bool Audio_buffer::initializePSRAM() {

  if (!psram.init()) {
    LOG_ERROR("PSRAM init or test failed");
    return false;
  }
  // NOTE: must stay AUDIO_BUFFER_BASE_ADDRESS, not some other offset - the
  // ring buffer spans [base, base + _psramBufferSize), and MusicLookup's
  // index is placed right after it at MUSIC_INDEX_BASE_ADDRESS. A stray
  // offset here (there used to be a leftover 0x100000 from an older memory
  // layout) makes the two regions overlap, so streaming past a few MB of
  // audio silently corrupts the music index the player is reading tracks
  // from.
  _psramBaseAddress = AUDIO_BUFFER_BASE_ADDRESS;

  LOG_INFO("PSRAM OK: %lu bytes", (unsigned long)_psramBufferSize);
  resetRingBuffer();
  return true;
}

void Audio_buffer::resetRingBuffer() {
  _psramHead = 0;
  _psramTail = 0;
  _bufferFull = false;
  _psramDataSize = 0;
  _psramPosition = 0;
}
uint32_t Audio_buffer::skipID3Header(FsFile &file) {
  uint8_t id3header[10];
  file.seekSet(0);
  if (file.read(id3header, 10) != 10)
    return 0;

  if (id3header[0] == 'I' && id3header[1] == 'D' && id3header[2] == '3') {
    return ((uint32_t)id3header[6] << 21) | ((uint32_t)id3header[7] << 14) |
           ((uint32_t)id3header[8] << 7) | (uint32_t)id3header[9] + 10;
  }

  return 0;
}

void Audio_buffer::setFileName(const char *filename,
                               uint32_t knownDurationSeconds) {
  if (file.isOpen()) {
    file.close();
  }
  strncpy(_currentFileName, filename, sizeof(_currentFileName) - 1);
  _currentFileName[sizeof(_currentFileName) - 1] =
      '\0';    // Ensure null-termination
  _openFailed = false;
  filePos = 0; // Reset file position
  _durationSeconds = knownDurationSeconds;
}
bool Audio_buffer::openFile() {
  if (!file.open(_currentFileName, O_RDONLY)) {
    LOG_ERROR("Can't open: %s", _currentFileName);
    return false;
  }
  fileSize = file.size();
  return true;
}

uint32_t Audio_buffer::pathHash(const char *path) {
  uint32_t h = 2166136261u;
  while (*path) {
    h = (h ^ (uint8_t)*path++) * 16777619u;
  }
  return h;
}

bool Audio_buffer::closeFile() {
  if (file.isOpen()) {
    file.close();
    return true;
  }
  return false;
}

bool Audio_buffer::SDtoPSRAM(bool nextFile) {
  // Prefetching with nothing queued (or a next track that didn't open).
  if (nextFile && (!_nextValid || !_nextFile.isOpen())) {
    return false;
  }
  if (!nextFile && _openFailed) {
    return false; // already reported, don't retry every tick
  }

  File &f = nextFile ? _nextFile : file;
  size_t &fsize = nextFile ? _nextFileSize : fileSize;
  int &fpos = nextFile ? _nextFilePos : filePos;
  uint32_t &dataStart = nextFile ? _nextDataStart : _dataStart;

  // A file's first chunk: the current track's file is opened here, the next
  // track's was by prepareNextTrack().
  bool fresh;
  if (nextFile) {
    fresh = !_nextStarted;
    _nextStarted = true;
  } else {
    fresh = !f.isOpen();
    if (fresh && !openFile()) {
      _openFailed = true;
      return false;
    }
  }
  if (fresh) {
    // fpos is 0 here for a fresh file (both setFileName() and
    // prepareNextTrack() reset it), so this always skips the ID3 header on
    // first read; a resumed fpos (e.g. after consumeNextTrackIfMatches())
    // re-seeks to where streaming left off instead.
    if (fpos) {
      dataStart = (uint32_t)fpos;
    } else {
      dataStart = skipFLACMetadata(f, skipID3Header(f), nextFile);
    }
    fpos = (int)dataStart;
    f.seekSet(dataStart);
    if (!nextFile) {
      // f.size() returns uint64_t, so passing it straight to %d/%lu misaligns
      // the varargs and garbles the log. Print the already-correct size_t
      // (fsize) and uint32_t duration with matching specifiers instead.
      LOG_CAT(AUDIO_BUFFER, "Loading file: %s, size: %u bytes, ~%u s",
              _currentFileName, (unsigned)fsize,
              (unsigned)_durationSeconds);
    }
  }

  size_t remainingFile = fsize - fpos;
  size_t freeSpace = nextFile
                         ? (NEXT_TRACK_BUFFER_SIZE - _nextPrefetchedBytes)
                         : getPSRAMFreeSpace();
  if (freeSpace == 0) {
    return false; // Destination is full, can't write more
  }

  size_t toRead =
      min(remainingFile, min((size_t)AUDIO_PRELOAD_CHUNK_SIZE, freeSpace));
  if (toRead == 0) {
    return false;
  }

  uint32_t t0 = audioprof::now();
  size_t read = f.read(_scratchBuffer, toRead);
  audioprof::add(audioprof::SD_READ, t0);
  audioprof::addBytes(audioprof::SD_READ, read);
  if (read == 0) {
    return false; // End of file
  }

  appendToDestination(nextFile, _scratchBuffer, read);
  fpos += read;

  return true;
}

void Audio_buffer::appendToDestination(bool nextFile, const uint8_t *data,
                                       size_t len) {
  if (nextFile) {
    psram.writeData(NEXT_TRACK_BUFFER_BASE_ADDRESS + _nextPrefetchedBytes,
                    data, len);
    _nextPrefetchedBytes += len;
    return;
  }
  if (_front && _frontBypass && getPSRAMDataSize() == 0 &&
      _front->freeSpace() >= len) {
    _front->write(data, len); // bypass PSRAM, see setFrontFifo()
    return;
  }
  bool wraps = (_psramHead + len) > _psramBufferSize;
  size_t writeSize = wraps ? (_psramBufferSize - _psramHead) : len;
  size_t wrapWriteSize = wraps ? (len - writeSize) : 0;
  psram.writeData(_psramBaseAddress + _psramHead, data, writeSize);
  if (wrapWriteSize > 0) {
    psram.writeData(_psramBaseAddress, data + writeSize, wrapWriteSize);
  }
  _psramHead = (_psramHead + len) % _psramBufferSize;
  if (_psramHead == _psramTail) {
    _bufferFull = true;
  }
  _psramDataSize += len;
  _psramPosition = 0;
}

uint32_t Audio_buffer::skipFLACMetadata(FsFile &f, uint32_t start,
                                        bool nextFile) {
  // A FLAC file is "fLaC", metadata blocks, then audio frames. The decoder
  // only needs STREAMINFO; the other blocks (embedded cover art: 200-300 KB
  // is common, seek table, tags, padding) would be streamed to the VS1053
  // for nothing, draining the freshly primed buffer at SPI speed and
  // starving the start of every track. Hand the decoder a minimal header
  // instead ("fLaC" + STREAMINFO flagged as the last block) and start
  // streaming at the first audio frame. Anything unexpected: stream the
  // file as-is.
  uint8_t header[4 + 4 + 34];
  f.seekSet(start);
  if (f.read(header, 4) != 4 || memcmp(header, "fLaC", 4) != 0) {
    return start;
  }
  bool haveStreamInfo = false;
  uint32_t pos = start + 4;
  for (;;) {
    uint8_t blockHeader[4];
    if (!f.seekSet(pos) || f.read(blockHeader, 4) != 4) {
      return start;
    }
    uint8_t type = blockHeader[0] & 0x7F;
    uint32_t len = ((uint32_t)blockHeader[1] << 16) |
                   ((uint32_t)blockHeader[2] << 8) | blockHeader[3];
    if (type == 0 && len == 34) {
      if (f.read(header + 8, 34) != 34) {
        return start;
      }
      haveStreamInfo = true;
    }
    pos += 4 + len;
    if (blockHeader[0] & 0x80) {
      break; // last metadata block
    }
    if (pos >= (nextFile ? _nextFileSize : fileSize)) {
      return start;
    }
  }
  if (!haveStreamInfo) {
    return start;
  }
  header[4] = 0x80; // STREAMINFO, last metadata block
  header[5] = 0;
  header[6] = 0;
  header[7] = 34;
  appendToDestination(nextFile, header, sizeof(header));
  LOG_CAT(AUDIO_BUFFER, "FLAC: skipped %lu bytes of metadata",
          (unsigned long)(pos - start - 4 - 4 - 34));
  return pos;
}
bool Audio_buffer::load(size_t targetBufferedBytes,
                        const std::function<void()> &onChunkLoaded,
                        uint32_t budgetUs) {
  uint32_t startUs = micros();
  uint8_t chunks = 0;
  while (!_bufferFull && getBufferedBytes() < targetBufferedBytes &&
         chunks < AUDIO_MAX_CHUNKS_PER_LOAD_CALL) {
    uint32_t elapsed = micros() - startUs;
    if (chunks > 0 && elapsed + _chunkCostUs > budgetUs) {
      break; // the next chunk wouldn't fit
    }
    uint32_t chunkStartUs = micros();
    if (!SDtoPSRAM()) {
      break; // buffer full or end of file
    }
    // EMA, 1/8 weight: follows a slower card or a busier bus within a
    // few chunks without jumping on a single outlier.
    uint32_t cost = micros() - chunkStartUs;
    _chunkCostUs = _chunkCostUs - _chunkCostUs / 8 + cost / 8;
    chunks++;
    if (onChunkLoaded) {
      onChunkLoaded();
    }
  }
  return true;
}

void Audio_buffer::prepareNextTrack(const char *filename,
                                    uint32_t knownDurationSeconds) {
  // Drop any previous (now-irrelevant) guess and its partial progress.
  _nextFile.close();
  _nextNameHash = pathHash(filename);
  _nextStarted = false;
  _nextFilePos = 0;
  _nextFileSize = 0;
  _nextDataStart = 0;
  _nextDurationSeconds = knownDurationSeconds;
  _nextPrefetchedBytes = 0;
  // Opened now, so the path needn't be kept: prefetchNextTrack() reads it
  // chunk by chunk until the track change.
  _nextValid = _nextFile.open(filename, O_RDONLY);
  if (_nextValid) {
    _nextFileSize = _nextFile.size();
  } else {
    LOG_ERROR("Can't open: %s", filename);
  }
}

bool Audio_buffer::prefetchNextTrack() {
  // Same open/skip-ID3/read-a-chunk operation SDtoPSRAM() does for the
  // current track, just aimed at the next-track prefetch region instead of
  // the main ring buffer - see SDtoPSRAM()'s nextFile branches.
  return SDtoPSRAM(true);
}

bool Audio_buffer::consumeNextTrackIfMatches(const char *filename,
                                             uint32_t knownDurationSeconds) {
  bool matches = _nextValid && _nextNameHash == pathHash(filename);
  bool hasPrefetchedData = matches && _nextPrefetchedBytes > 0;
  bool adopted = false;

  if (hasPrefetchedData) {
    // Only the start of the prefetch is adopted: copying the whole region
    // (up to 1 MB) PSRAM -> PSRAM blocked the track change for ~1.6 s. A
    // fifo's worth is enough to start instantly; the file is reopened right
    // after the adopted bytes and the normal refill reads the rest. The
    // region may start with a synthetic FLAC header (no file bytes), so the
    // resume offset is counted back from where the prefetch stopped.
    uint32_t adoptBytes =
        min(_nextPrefetchedBytes, (uint32_t)NEXT_TRACK_ADOPT_MAX_BYTES);
    uint32_t adoptFilePos =
        (uint32_t)_nextFilePos - (_nextPrefetchedBytes - adoptBytes);
    uint32_t adoptDataStart = _nextDataStart;
    uint32_t adoptDuration =
        knownDurationSeconds ? knownDurationSeconds : _nextDurationSeconds;
    size_t prefetchedFileSize = _nextFileSize;

    _nextFile.close();
    closeFile();
    strncpy(_currentFileName, filename, sizeof(_currentFileName) - 1);
    _currentFileName[sizeof(_currentFileName) - 1] = '\0';
    _openFailed = false;
    // Don't rely on File copy-assignment to "move" the open next-track
    // handle over - SdFat handle semantics vary by version/backend. Closing
    // and reopening at the resumed position is just a directory lookup +
    // seek (not a data re-read), and is safe regardless. openFile()
    // reopens _currentFileName (set above) and refreshes fileSize from it -
    // the same helper SDtoPSRAM() uses for a fresh current-track open.
    // Same size as the prefetched file: a guard against a path hash clash.
    if (openFile() && fileSize == prefetchedFileSize &&
        file.seekSet(adoptFilePos)) {
      filePos = (int)adoptFilePos;
      _dataStart = adoptDataStart;
      _durationSeconds = adoptDuration;

      // Same path as SD chunks: straight into the front fifo while the
      // ring is empty (stopPlaying() emptied both), else the ring.
      uint32_t remaining = adoptBytes;
      uint32_t srcOffset = 0;
      while (remaining > 0) {
        size_t chunk =
            (size_t)min((uint32_t)AUDIO_PRELOAD_CHUNK_SIZE, remaining);
        psram.readData(NEXT_TRACK_BUFFER_BASE_ADDRESS + srcOffset,
                       _scratchBuffer, chunk);
        appendToDestination(false, _scratchBuffer, chunk);
        srcOffset += chunk;
        remaining -= chunk;
      }
      LOG_CAT(AUDIO_BUFFER, "Adopted %lu prefetched bytes for %s",
              (unsigned long)adoptBytes, filename);
      adopted = true;
    } else {
      LOG_WARN("Adopt: failed to reopen prefetched track: %s",
               filename);
    }
  }

  // Whether we matched, adopted, or not: this slot's guess is now spent for
  // this transition. Free it so the caller can prepareNextTrack() again for
  // whatever follows the track that's about to start.
  _nextFile.close();
  _nextValid = false;
  _nextStarted = false;
  _nextPrefetchedBytes = 0;
  _nextFilePos = 0;
  _nextFileSize = 0;
  _nextDataStart = 0;
  _nextDurationSeconds = 0;

  return adopted;
}

void Audio_buffer::invalidateNextTrack() {
  _nextFile.close();
  _nextValid = false;
  _nextStarted = false;
  _nextFilePos = 0;
  _nextFileSize = 0;
  _nextDataStart = 0;
  _nextDurationSeconds = 0;
  _nextPrefetchedBytes = 0;
}

size_t Audio_buffer::readData(uint8_t *buffer, size_t maxLen) {
  if ((_psramTail == _psramHead) && !_bufferFull)
    return 0;

  size_t available = getPSRAMDataSize();
  size_t toRead = (maxLen < available) ? maxLen : available;
  
  if (toRead == 0)
    return 0;

  // Handle ring buffer wrapping
  size_t firstChunk = (toRead < (_psramBufferSize - _psramTail)) ? toRead : (_psramBufferSize - _psramTail);
  size_t secondChunk = toRead - firstChunk;

  psram.readData(_psramBaseAddress + _psramTail, buffer, firstChunk);
  if (secondChunk > 0)
    psram.readData(_psramBaseAddress, buffer + firstChunk, secondChunk);

  _psramTail = (_psramTail + toRead) % _psramBufferSize;
  _bufferFull = false;

  return toRead;
}

size_t Audio_buffer::fillFrontFromPSRAM(size_t maxBytes, size_t chunk) {
  if (!_front) {
    return 0;
  }
  size_t moved = 0;
  while (moved < maxBytes && _front->freeSpace() >= chunk &&
         getPSRAMDataSize() > 0) {
    uint32_t contig;
    uint8_t *dst = _front->writePtr(contig);
    size_t want = min(min((size_t)contig, chunk), maxBytes - moved);
    size_t got = readData(dst, want);
    if (got == 0) {
      break;
    }
    _front->commit(got);
    moved += got;
  }
  return moved;
}

bool Audio_buffer::seekToSeconds(uint32_t targetSeconds) {
  if (!file.isOpen() || _durationSeconds == 0) {
    return false;
  }
  targetSeconds = min(targetSeconds, _durationSeconds);
  uint32_t audioBytes = (fileSize > _dataStart) ? (fileSize - _dataStart) : 0;
  if (audioBytes == 0) {
    return false;
  }
  uint32_t bytesPerSecond = audioBytes / max(_durationSeconds, (uint32_t)1);
  uint32_t targetPos = _dataStart + targetSeconds * bytesPerSecond;
  if (targetPos >= fileSize) {
    targetPos = fileSize > 0 ? fileSize - 1 : 0;
  }
  if (!file.seekSet(targetPos)) {
    return false;
  }
  filePos = (int)targetPos;
  // Discard stale pre-seek buffered audio.
  resetRingBuffer();
  return true;
}

size_t Audio_buffer::getPSRAMDataSize() {
  if (_bufferFull)
    return _psramBufferSize;
  return (_psramHead >= _psramTail)
             ? (_psramHead - _psramTail)
             : (_psramBufferSize - (_psramTail - _psramHead));
}
size_t Audio_buffer::getPSRAMFreeSpace() {
  return _psramBufferSize - getPSRAMDataSize();
}

bool Audio_buffer::isFileExhausted() {
  if (_bufferFull) {
    return false;
  }
  if (getPSRAMDataSize() != 0) {
    return false;
  }
  if (_front && _front->size() != 0) {
    return false;
  }
  // Every byte of the source file has been pulled into (and consumed from)
  // the ring buffer.
  return (size_t)filePos >= fileSize;
}
