Leo-Nicolle/open-pod/software/src/storage/Music_index.cpp

#include "Music_index.h"
#include "../sound/AudioYield.h"
#include "../logging.h"

MusicIndex::MusicIndex() : initialized(false) {
  memset(&header, 0, sizeof(header));
  memset(&trie, 0, sizeof(trie));
  memset(&node_batch, 0, sizeof(node_batch));
  node_batch.start_index = UINT32_MAX;
}

MusicIndex::~MusicIndex() {}

// The trie stays on the SD card, in index.pack: it's read through the PSRAM
// page cache (PageStore.h) as searches walk it.
bool MusicIndex::init(const PackRef &trieSection) {
  initialized = false;
  trie = trieSection;
  if (trie.length < sizeof(trie_header_t) ||
      !pageStore.read(trie, 0, &header, sizeof(header))) {
    LOG_ERROR("No search trie in index.pack");
    return false;
  }
  LOG_CAT(INDEX_USAGE,
          "Trie - String pool: %lu, Nodes: %lu, Results: %lu, "
          "String offsets: %lu",
          (unsigned long)header.string_pool_size,
          (unsigned long)header.node_count, (unsigned long)header.result_count,
          (unsigned long)header.string_offset_count);

  // Offsets within the section
  string_pool_offset = sizeof(trie_header_t);
  string_offsets_offset = string_pool_offset + header.string_pool_size;
  nodes_offset = string_offsets_offset + (header.string_offset_count * 4);
  results_offset = nodes_offset + (header.node_count * sizeof(trie_node_t));
  uint64_t end = (uint64_t)results_offset +
                 (uint64_t)header.result_count * sizeof(search_result_t);
  if (end > trie.length) {
    LOG_ERROR("Search trie is truncated");
    return false;
  }

  initialized = true;
  node_batch.start_index = UINT32_MAX;
  node_batch.count = 0;
  return true;
}

void MusicIndex::readString(uint32_t offset, uint32_t length, char *buffer,
                             uint32_t buffer_size) {
  uint32_t copy_len = min(length, buffer_size - 1);
  pageStore.read(trie, string_pool_offset + offset, buffer, copy_len);
  buffer[copy_len] = '\0';
}

void MusicIndex::loadNodeBatch(uint32_t start_index, uint32_t count) {
  // Limit count to batch size
  count = min(count, (uint32_t)NODE_BATCH_SIZE);

  // Update batch info
  node_batch.start_index = start_index;
  node_batch.count = count;

  // Read all nodes in one PSRAM operation
  uint32_t addr = nodes_offset + (start_index * sizeof(trie_node_t));
  pageStore.read(trie, addr, node_batch.nodes, count * sizeof(trie_node_t));
}

trie_node_t *MusicIndex::getNodeFromBatch(uint32_t node_index) {
  // Check if node is in current batch
  if (node_index >= node_batch.start_index &&
      node_index < node_batch.start_index + node_batch.count) {
    return &node_batch.nodes[node_index - node_batch.start_index];
  }
  return nullptr;
}

trie_node_t MusicIndex::readNode(uint32_t node_index) {
  trie_node_t *node = getNodeFromBatch(node_index);
  if (node) {
    return *node;
  }
  // Its next siblings come with it.
  uint32_t count = NODE_BATCH_SIZE;
  if (node_index < header.node_count &&
      node_index + count > header.node_count) {
    count = header.node_count - node_index;
  }
  loadNodeBatch(node_index, count);
  node = getNodeFromBatch(node_index);
  if (node) {
    return *node;
  }
  trie_node_t single;
  memset(&single, 0, sizeof(single));
  pageStore.read(trie, nodes_offset + node_index * sizeof(trie_node_t), &single,
                 sizeof(single));
  return single;
}

void MusicIndex::loadResultBatch(uint32_t start_index, search_result_t *results,
                                 uint32_t count) {
  // Read all results in one PSRAM operation
  uint32_t addr = results_offset + (start_index * sizeof(search_result_t));
  pageStore.read(trie, addr, results, count * sizeof(search_result_t));
}

uint32_t MusicIndex::findNode(const char *query, uint32_t query_len) {
  if (!initialized || query_len == 0) {
    return UINT32_MAX;
  }

  uint32_t current_node = 0;
  uint32_t remaining_query_len = query_len;
  const char *remaining_query = query;

  while (remaining_query_len > 0) {
    trie_node_t node = readNode(current_node);
    bool found_child = false;

    // Load all children in a batch if there are many
    if (node.child_count > 4) {
      loadNodeBatch(node.first_child_offset,
                    min(node.child_count, (uint32_t)NODE_BATCH_SIZE));
    }

    // Check all children of current node
    for (uint32_t i = 0; i < node.child_count; i++) {
      if ((i & 7) == 7) {
        audioYield(); // the root has a child per first letter/word: many reads
      }
      uint32_t child_index = node.first_child_offset + i;
      trie_node_t child = readNode(child_index);

      // Read child's key
      char child_key[64];
      readString(child.key_offset, child.key_length, child_key,
                       sizeof(child_key));

      uint32_t common_len =
          getCommonPrefixLength(remaining_query, child_key,
                                min(remaining_query_len, child.key_length));

      if (common_len > 0) {
        if (common_len == child.key_length) {
          // Full match of child key, continue with remaining query
          current_node = child_index;
          remaining_query += common_len;
          remaining_query_len -= common_len;
          found_child = true;
          break;
        } else if (common_len == remaining_query_len) {
          // Query is a prefix of child key - found our target node
          return child_index;
        }
      }
    }

    if (!found_child) {
      return UINT32_MAX;
    }
  }

  return current_node;
}

// Reads results in small batches: a stack buffer of RESULT_BATCH_SIZE, in a
// frame of its own so collectResults()'s recursion doesn't carry it.
__attribute__((noinline)) void
MusicIndex::visitResults(uint32_t start_index, uint32_t count,
                         SearchVisitor visit, void *ctx) {
  search_result_t batch[RESULT_BATCH_SIZE];
  while (count > 0) {
    uint32_t n = min(count, (uint32_t)RESULT_BATCH_SIZE);
    loadResultBatch(start_index, batch, n);
    for (uint32_t i = 0; i < n; i++) {
      visit(batch[i], ctx);
    }
    start_index += n;
    count -= n;
  }
}

void MusicIndex::collectResults(uint32_t node_index, SearchVisitor visit,
                                void *ctx, uint32_t *result_count,
                                uint32_t max_results) {
  if (*result_count >= max_results || node_index == UINT32_MAX) {
    return;
  }

  // A short prefix's subtree spans hundreds of nodes: keep the audio fifo
  // topped up while walking it.
  audioYield();
  trie_node_t node = readNode(node_index);

  if (node.result_count > 0) {
    uint32_t results_to_load =
        min(node.result_count, max_results - *result_count);
    visitResults(node.first_result_offset, results_to_load, visit, ctx);
    *result_count += results_to_load;
  }

  // Batch load children for recursive collection
  if (node.child_count > 0 && *result_count < max_results) {
    loadNodeBatch(node.first_child_offset,
                  min(node.child_count, (uint32_t)NODE_BATCH_SIZE));

    // Recursively collect from children
    for (uint32_t i = 0; i < node.child_count && *result_count < max_results;
         i++) {
      collectResults(node.first_child_offset + i, visit, ctx, result_count,
                     max_results);
    }
  }
}

uint32_t MusicIndex::searchByPrefix(const char *prefix, SearchVisitor visit,
                                    void *ctx, uint32_t max_results) {
  if (!initialized || !prefix || !visit) {
    return 0;
  }

  uint32_t prefix_len = strlen(prefix);
  if (prefix_len == 0) {
    return 0;
  }

  // Find the node that matches the prefix
  uint32_t node_index = findNode(prefix, prefix_len);
  if (node_index == UINT32_MAX) {
    return 0;
  }

  // Visit all results from this node and its children
  uint32_t result_count = 0;
  collectResults(node_index, visit, ctx, &result_count, max_results);

  return result_count;
}

namespace {
struct ArraySink {
  search_result_t *results;
  uint32_t count;
};
void storeResult(const search_result_t &result, void *ctx) {
  ArraySink *sink = (ArraySink *)ctx;
  sink->results[sink->count++] = result;
}
} // namespace

uint32_t MusicIndex::searchByPrefix(const char *prefix,
                                    search_result_t *results,
                                    uint32_t max_results) {
  if (!results) {
    return 0;
  }
  ArraySink sink = {results, 0};
  return searchByPrefix(prefix, storeResult, &sink, max_results);
}

uint32_t MusicIndex::searchArtists(const char *prefix, search_result_t *results,
                                   uint32_t max_results) {
  search_result_t all_results[MAX_SEARCH_RESULTS];
  uint32_t total_results =
      searchByPrefix(prefix, all_results, MAX_SEARCH_RESULTS);

  uint32_t artist_count = 0;
  for (uint32_t i = 0; i < total_results && artist_count < max_results; i++) {
    if (all_results[i].type == SEARCH_ARTIST) {
      results[artist_count++] = all_results[i];
    }
  }

  return artist_count;
}

uint32_t MusicIndex::searchAlbums(const char *prefix, search_result_t *results,
                                  uint32_t max_results) {
  search_result_t all_results[MAX_SEARCH_RESULTS];
  uint32_t total_results =
      searchByPrefix(prefix, all_results, MAX_SEARCH_RESULTS);

  uint32_t album_count = 0;
  for (uint32_t i = 0; i < total_results && album_count < max_results; i++) {
    if (all_results[i].type == SEARCH_ALBUM) {
      results[album_count++] = all_results[i];
    }
  }

  return album_count;
}

uint32_t MusicIndex::searchTracks(const char *prefix, search_result_t *results,
                                  uint32_t max_results) {
  search_result_t all_results[MAX_SEARCH_RESULTS];
  uint32_t total_results =
      searchByPrefix(prefix, all_results, MAX_SEARCH_RESULTS);

  uint32_t track_count = 0;
  for (uint32_t i = 0; i < total_results && track_count < max_results; i++) {
    if (all_results[i].type == SEARCH_TRACK) {
      results[track_count++] = all_results[i];
    }
  }

  return track_count;
}

uint32_t MusicIndex::searchGenres(const char *prefix, search_result_t *results,
                                  uint32_t max_results) {
  search_result_t all_results[MAX_SEARCH_RESULTS];
  uint32_t total_results =
      searchByPrefix(prefix, all_results, MAX_SEARCH_RESULTS);

  uint32_t genre_count = 0;
  for (uint32_t i = 0; i < total_results && genre_count < max_results; i++) {
    if (all_results[i].type == SEARCH_GENRE) {
      results[genre_count++] = all_results[i];
    }
  }

  return genre_count;
}

void MusicIndex::getResultName(const search_result_t &result, char *buffer,
                               uint32_t buffer_size) {
  readString(result.name_offset, result.name_length, buffer, buffer_size);
}

const char *MusicIndex::getSearchTypeName(SearchType type) {
  switch (type) {
  case SEARCH_TRACK:
    return "Track";
  case SEARCH_ARTIST:
    return "Artist";
  case SEARCH_ALBUM:
    return "Album";
  case SEARCH_GENRE:
    return "Genre";
  default:
    return "Unknown";
  }
}

void MusicIndex::printStats() {
  if (!initialized) {
    LOG_WARN("Music index not initialized");
    return;
  }
  LOG_INFO("=== MUSIC INDEX STATS ===\n"
           "String pool size: %lu bytes\n"
           "Node count: %lu\n"
           "Result count: %lu\n"
           "String offset count: %lu\n"
           "Trie section: %lu bytes at pack offset 0x%lX\n"
           "========================",
           (unsigned long)header.string_pool_size,
           (unsigned long)header.node_count, (unsigned long)header.result_count,
           (unsigned long)header.string_offset_count,
           (unsigned long)trie.length, (unsigned long)trie.offset());
}

void MusicIndex::printSearchResult(const search_result_t &result) {
  char name[128];
  getResultName(result, name, sizeof(name));

  LOG_INFO("[%s] %s (ID: %lu, Relevance: %lu)",
           getSearchTypeName((SearchType)result.type), name,
           (unsigned long)result.id, (unsigned long)result.relevance);
}
