Leo-Nicolle/open-pod/software/src/sound/VS1053_FLAC_plugin.h

/*!
 * @file VS1053_FLAC_plugin.h
 * Complete FLAC plugin data for VS1053b audio decoder
 * 
 * This file contains the complete FLAC decoder plugin from VLSI Solution
 * that enables FLAC audio format support on the VS1053b chip.
 * 
 * Plugin version: FLAC decoder for VS1053b
 * Source: VLSI Solution official plugin
 * Format support: FLAC up to 48kHz/24-bit
 */

#ifndef VS1053_FLAC_PLUGIN_H
#define VS1053_FLAC_PLUGIN_H

#include <Arduino.h>

// FLAC Plugin Address Table (atab)
// Specifies the register addresses for each data word
static const uint8_t flacPluginAddresses[8208] PROGMEM = {
 		0x7, 0x6, 0x6, 0x6, 0x6, 0x6, 0x6, 0x6, 0x6, 0x6, 0x6, 0x6, 0x6, 0x6, 0x6, 0x6,
		0x6, 0x6, 0x6, 0x6, 0x6, 0x6, 0x6, 0x6, 0x6, 0x6, 0x6, 0x6, 0x6, 0x6, 0x6, 0x7,
		0x6, 0x6, 0x6, 0x6, 0x6, 0x6, 0x6, 0x6, 0x6, 0x6, 0x6, 0x6, 0x6, 0x6, 0x6, 0x6,
		0x6, 0x6, 0x6, 0x6, 0x6, 0x6, 0x6, 0x6, 0x6, 0x6, 0x6, 0x6, 0x6, 0x6, 0x6, 0x6,
		0x6, 0x6, 0x6, 0x6, 0x6, 0x6, 0x6, 0x6, 0x6, 0x6, 0x6, 0x6, 0x6, 0x6, 0x6, 0x6,
		0x6, 0x6, 0x6, 0x6, 0x6, 0x6, 0x6, 0x6, 0x6, 0x6, 0x6, 0x6, 0x6, 0x6, 0x6, 0x6,
		0x6, 0x6, 0x6, 0x6, 0x6, 0x6, 0x6, 0x6, 0x6, 0x6, 0x6, 0x6, 0x6, 0x6, 0x6, 0x6,
		0x6, 0x6, 0x6, 0x6, 0x6, 0x6, 0x6, 0x6, 0x6, 0x6, 0x6, 0x6, 0x6, 0x6, 0x6, 0x6,
		0x6, 0x6, 0x6, 0x6, 0x6, 0x6, 0x6, 0x6, 0x6, 0x6, 0x6, 0x6, 0x6, 0x6, 0x6, 0x6,
		0x6, 0x6, 0x6, 0x6, 0x6, 0x6, 0x6, 0x6, 0x6, 0x6, 0x6, 0x6, 0x6, 0x6, 0x6, 0x6,
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
		0x0000, 0x0024, 0x2800, 0x2fc5, 0x0000, 0x0024, 0x3613, 0x0024,
		0x3e10, 0x3813, 0x3e14, 0x8024, 0x3e04, 0x8024, 0x2900, 0x4880,
		0x0006, 0x02d3, 0x36e3, 0x0024, 0x3009, 0x1bd3, 0x0007, 0x8257,
		0x3700, 0x8024, 0xf224, 0x0024, 0x0000, 0x0024, 0x2800, 0x31d1,
		0x3600, 0x9844, 0x2900, 0x3780, 0x0000, 0x3248, 0x2911, 0xf140,
		0x0000, 0x0024, 0x0030, 0x0057, 0x3700, 0x0024, 0xf200, 0x4595,
		0x0fff, 0xfe02, 0xa024, 0x164c, 0x8000, 0x17cc, 0x3f00, 0x0024,
		0x3500, 0x0024, 0x0021, 0x6d82, 0xd024, 0x44c0, 0x0006, 0xa402,
		0x2800, 0x3695, 0xd024, 0x0024, 0x0000, 0x0000, 0x2800, 0x3695,
		0x000b, 0x6d57, 0x3009, 0x3c00, 0x36f0, 0x8024, 0x36f2, 0x1800,
		0x2000, 0x0000, 0x0000, 0x0024, 0x3e14, 0x7810, 0x3e13, 0xb80d,
		0x3e13, 0xf80a, 0x3e10, 0xb803, 0x3e11, 0x3805, 0x3e11, 0xb807,
		0x3e14, 0xf801, 0x3e15, 0x3815, 0x0001, 0x000a, 0x0006, 0xc4d7,
		0xbf8e, 0x9c42, 0x3e01, 0x9c03, 0x0006, 0xa017, 0x0023, 0xffd1,
		0x0007, 0x8250, 0x0fff, 0xfd85, 0x3001, 0x0024, 0xa45a, 0x4494,
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
};

// Plugin size constant
#define FLAC_PLUGIN_SIZE 8208

// Helper function to get plugin size
inline uint16_t getFLACPluginSize() {
  return FLAC_PLUGIN_SIZE;
}

#endif // VS1053_FLAC_PLUGIN_H
