Leo-Nicolle/open-pod/(commit log)

2020-04-10 fix printing menus on screen
    [main.cpp]
2020-04-10 draw a battery
2020-04-17 first version of sensing wheel for scrolling
2020-04-17 magic hat: fix display problem ... weird
    [main.cpp]
2025-07-06 Rebirth (#2)
    * designed clickwheel and see if mpr121 can fit on it
    * update power and audio
    * added UART converter
    * added bluetooth
    * try up with vs1053 feather
    * setupt the player file
    * fill screen with different colors
    * almost works with GFX, just wrong coordinates
    * test MADCTL 1
    * wrong, screen is all white
    * screen pins before remap
    * new pinout with consecutive 16bits on the PCs pins
    * screen works
    * added demo
    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
    [audio.kicad_sch, bluetooth.kicad_sch, buttons.kicad_sch, hirose-connector-8.stp, openpod.csv, openpod.kicad_pcb, openpod.kicad_sch, power.kicad_sch]
2026-09-18 fixed accents and startup
    [AudioPlayer.h, PSRAM_controller.hpp, VS1053_driver.cpp, VS1053_driver.h]
2026-09-19 restore navigation and track selection, plus playback
2026-09-19 fixed indexing bounds problem
    [Music_lookup.cpp]
2026-09-20 dev boards
    [audio.kicad_sch, bluetooth.kicad_sch, bt_devboard.kicad_pcb, bt_devboard.kicad_sch, buttons.kicad_sch, click-wheel-base-devboard.kicad_pcb, click-wheel-base-devboard.kicad_sch, openpod.kicad_pcb]
2026-09-20 better footprint for the bluetoot board
2026-10-09 added buttons to the clickwheel
2026-10-09 updated mapping to include the buttons
2026-10-09 wired the haptic motor and improved the scrolling wheel
2026-10-09 Try to make the next/prev track faster
2026-10-09 Feed the VS1053 from a timer interrupt via an L1 RAM fifo
    Playback no longer depends on how often the main loop comes around: long
    UI work (screen transitions, Now Playing render, list paging) used to
    starve the VS1053, whose own buffer only holds ~16 ms of MP3 data / 12 KiB
    with the FLAC plugin.
    Audio path
    - AudioFifo: 32 KB lock-free SPSC buffer in MCU RAM (~350 ms of FLAC).
    The main loop fills it, a 1 kHz TIM7 interrupt (lowest priority) drains
    it to the VS1053 while DREQ is high, max 512 B per tick.
    - Audio_buffer: while the PSRAM ring is empty (track start, seek), SD
    chunks go straight into the fifo; otherwise PSRAM -> fifo top-ups.
    Track start primes 24 KB straight to the fifo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
2026-10-16 added notes on the blog about the clickwheel gears
